jpanos/ECE477-PCB/ECE477.kicad_pcb

## KiCad design ECE477.kicad_pcb (2020-10-26)

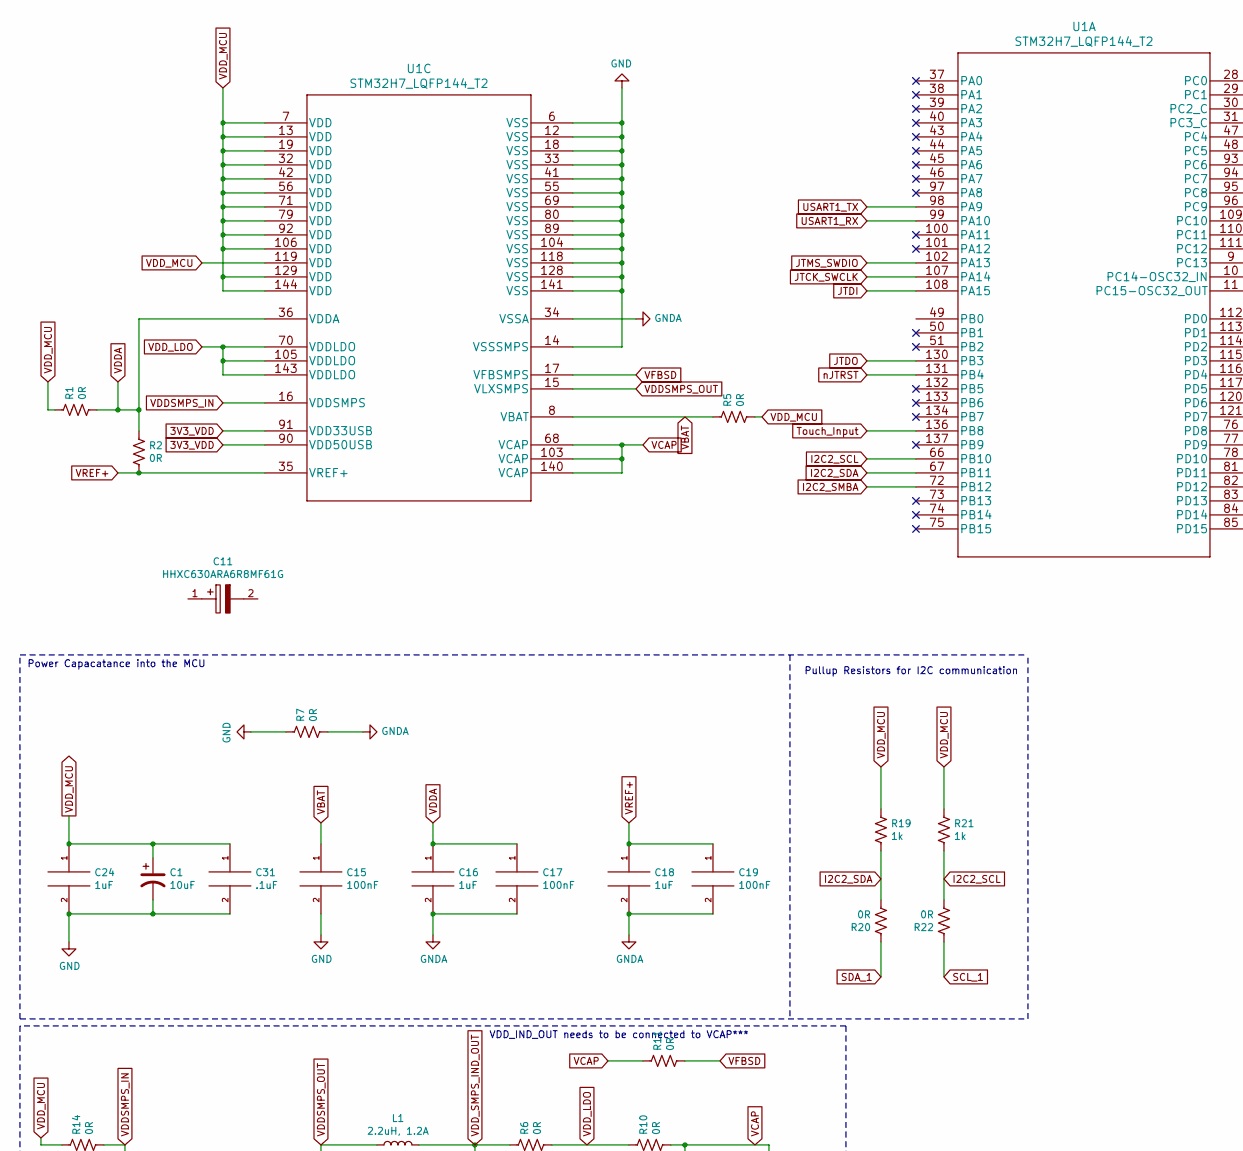
[picture p1: schematic ECE477.sch, ECE 477 PCB, part in row 1, column 1]

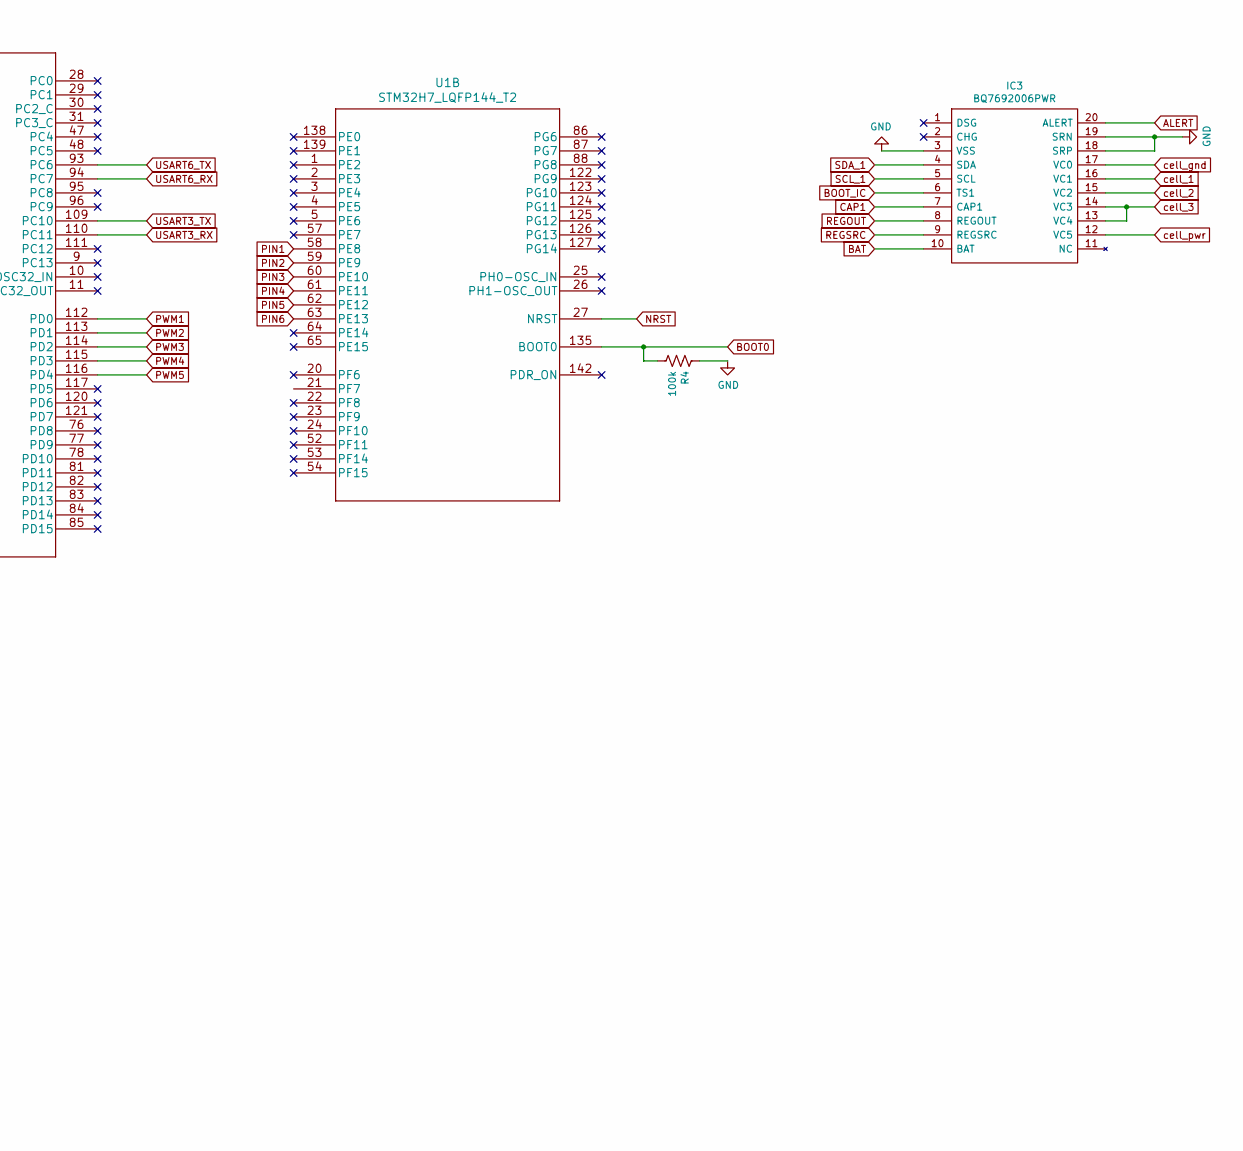
[picture p2: schematic ECE477.sch, ECE 477 PCB, part in row 1, column 2]

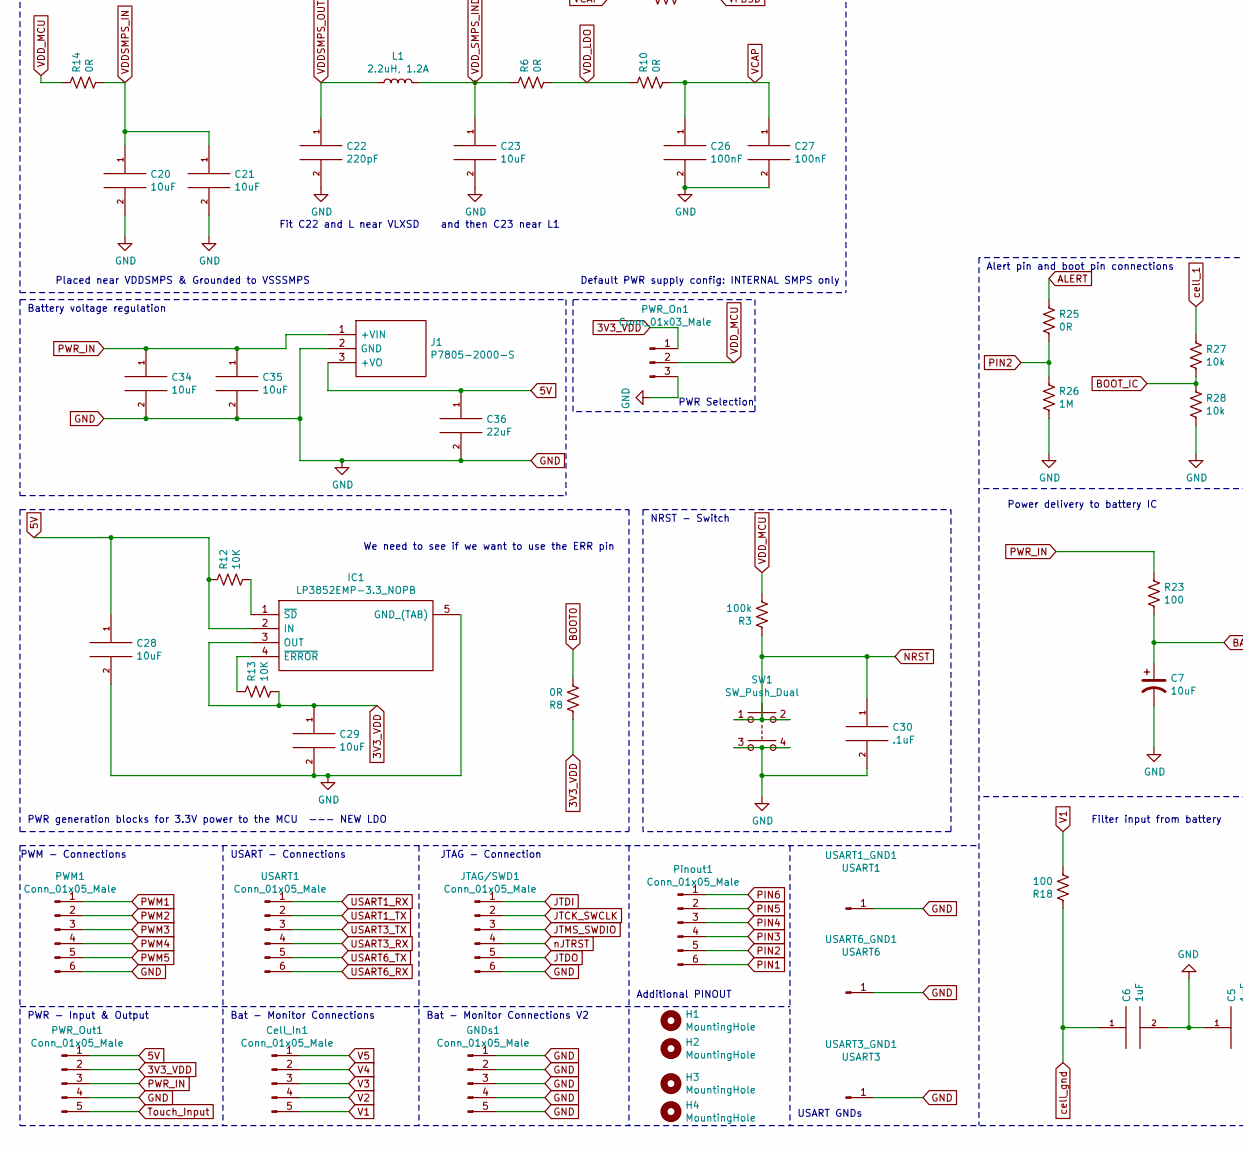
[picture p3: schematic ECE477.sch, ECE 477 PCB, part in row 2, column 1]

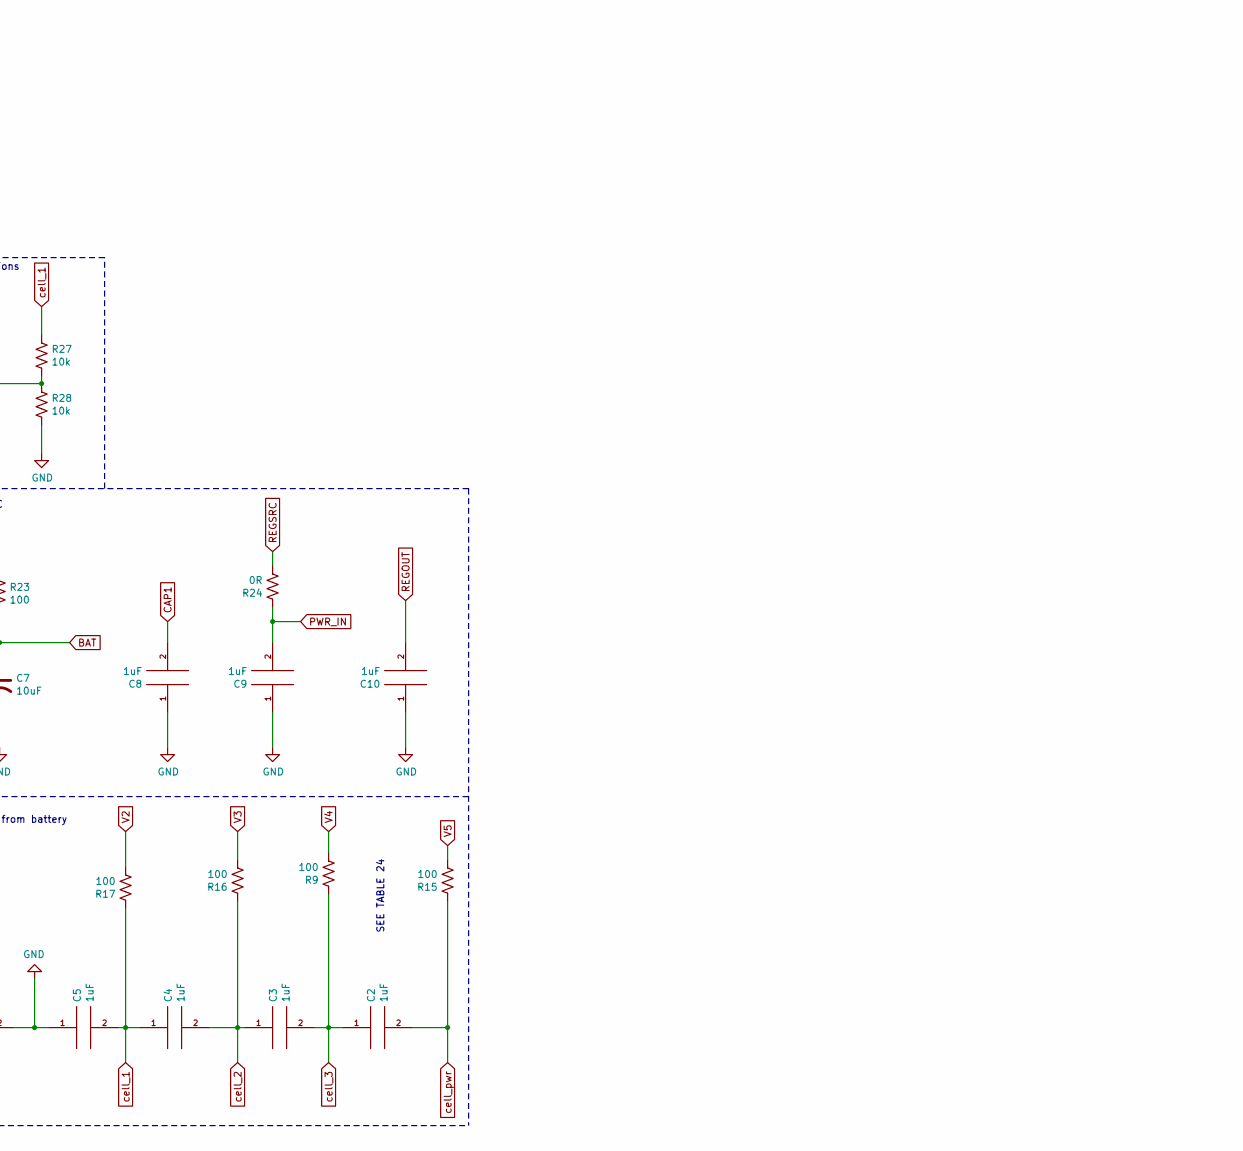
[picture p4: schematic ECE477.sch, ECE 477 PCB, part in row 2, column 2]

Parts:
C1, C7: 10uF; CP_Radial_D5.0mm_P2.50mm
C2, C3, C4, C5, C6, C8, C9, C10, C16, C18, C24: 1uF; C_0805_2012Metric_Pad1.15x1.40mm_HandSolder
C11: HHXC630ARA6R8MF61G; CAPAE660X610N; Mouser Part Number 661-HHXC630A6R8MF61G
C15, C17, C19, C26, C27: 100nF; C_0805_2012Metric_Pad1.15x1.40mm_HandSolder
C20, C21, C23, C28, C29, C34, C35: 10uF; C_0805_2012Metric_Pad1.15x1.40mm_HandSolder
C22: 220pF; C_0805_2012Metric_Pad1.15x1.40mm_HandSolder
C30, C31: .1uF; C_0805_2012Metric_Pad1.15x1.40mm_HandSolder
C36: 22uF; C_0805_2012Metric_Pad1.15x1.40mm_HandSolder
Cell_In1: Conn_01x05_Male; PinHeader_1x05_P2.54mm_Vertical
GNDs1: Conn_01x05_Male; PinHeader_1x05_P2.54mm_Vertical
H1, H2, H3, H4: MountingHole; MountingHole_3.2mm_M3_ISO14580
IC1: LP3852EMP-3.3_NOPB; SOT150P700X180-5N; Mouser Part Number 926-LP3852EMP33NOPB
IC3: BQ7692006PWR; SOP65P640X120-20N; Mouser Part Number 595-BQ7692006PWR
J1: P7805-2000-S; P78052000S; Mouser Part Number 490-P7805-2000-S
JTAG/SWD1: Conn_01x05_Male; PinHeader_1x06_P2.54mm_Vertical
L1: 2.2uH, 1.2A; L_0805_2012Metric_Pad1.15x1.40mm_HandSolder
PWM1: Conn_01x05_Male; PinHeader_1x06_P2.54mm_Vertical
PWR_On1: Conn_01x03_Male; PinHeader_1x03_P2.54mm_Vertical
PWR_Out1: Conn_01x05_Male; PinHeader_1x05_P2.54mm_Vertical
Pinout1: Conn_01x05_Male; PinHeader_1x06_P2.54mm_Vertical
R1, R2, R5, R6, R7, R8, R10, R11, R14, R20, R22, R24, R25: 0R; R_0805_2012Metric_Pad1.15x1.40mm_HandSolder
R3, R4: 100k; R_0805_2012Metric_Pad1.15x1.40mm_HandSolder
R9, R15, R16, R17, R18, R23: 100; R_0805_2012Metric_Pad1.15x1.40mm_HandSolder
R12, R13: 10K; R_0805_2012Metric_Pad1.15x1.40mm_HandSolder
R19, R21: 1k; R_0805_2012Metric_Pad1.15x1.40mm_HandSolder
R26: 1M; R_0805_2012Metric_Pad1.15x1.40mm_HandSolder
R27, R28: 10k; R_0805_2012Metric_Pad1.15x1.40mm_HandSolder
SW1: SW_Push_Dual; SW_TH_Tactile_Omron_B3F-10xx
U1: STM32H7_LQFP144_T2
USART1: Conn_01x05_Male; PinHeader_1x06_P2.54mm_Vertical
USART1_GND1: USART1; PinHeader_1x01_P2.54mm_Vertical
USART3_GND1: USART3; PinHeader_1x01_P2.54mm_Vertical
USART6_GND1: USART6; PinHeader_1x01_P2.54mm_Vertical

Connections:
3V3_VDD: C29.1, IC1.3 (OUT), PWR_On1.1, PWR_Out1.2, R8.1, R13.2, U1.90 (VDD50USB), U1.91 (VDD33USB)
5V: C28.1, C36.1, IC1.2 (IN), J1.3 (+VO), PWR_Out1.1, R12.1
ALERT: IC3.20 (ALERT), R25.1
BAT: C7.1, IC3.10 (BAT), R23.2
BOOT0: R4.2, R8.2, U1.135 (BOOT0)
BOOT_IC: IC3.6 (TS1), R27.2, R28.1
CAP1: C8.2, IC3.7 (CAP1)
GND: C1.2, C5.1, C6.2, C7.2, C8.1, C9.1, C10.1, C15.2, C20.2, C21.2, C22.2, C23.2, C24.2, C26.2, C27.2, C28.2, C29.2, C30.2, C31.2, C34.2, C35.2, C36.2, GNDs1.1, GNDs1.2, GNDs1.3, GNDs1.4, GNDs1.5, IC1.5 (GND_(TAB)), IC3.3 (VSS), IC3.18 (SRP), IC3.19 (SRN), J1.2 (GND), JTAG/SWD1.6, PWM1.6, PWR_On1.3, PWR_Out1.4, R4.1, R7.1, R26.2, R28.2, SW1.3, SW1.4, U1.6 (VSS), U1.12 (VSS), U1.14 (VSSSMPS), U1.18 (VSS), U1.33 (VSS), U1.41 (VSS), U1.55 (VSS), U1.69 (VSS), U1.80 (VSS), U1.89 (VSS), U1.104 (VSS), U1.118 (VSS), U1.128 (VSS), U1.141 (VSS), USART1_GND1.1, USART3_GND1.1, USART6_GND1.1
GNDA: C16.2, C17.2, C18.2, C19.2, R7.2, U1.34 (VSSA)
I2C2_SCL: R21.2, R22.2, U1.66 (PB10)
I2C2_SDA: R19.2, R20.2, U1.67 (PB11)
I2C2_SMBA: U1.72 (PB12)
JTCK_SWCLK: JTAG/SWD1.2, U1.107 (PA14)
JTDI: JTAG/SWD1.1, U1.108 (PA15)
JTDO: JTAG/SWD1.5, U1.130 (PB3)
JTMS_SWDIO: JTAG/SWD1.3, U1.102 (PA13)
NRST: C30.1, R3.1, SW1.1, SW1.2, U1.27 (NRST)
unnamed: IC1.1 (~SD), R12.2
unnamed: IC1.4 (~ERROR), R13.1
PIN1: Pinout1.6, U1.58 (PE8)
PIN2: Pinout1.5, R25.2, R26.1, U1.59 (PE9)
PIN3: Pinout1.4, U1.60 (PE10)
PIN4: Pinout1.3, U1.61 (PE11)
PIN5: Pinout1.2, U1.62 (PE12)
PIN6: Pinout1.1, U1.63 (PE13)
PWM1: PWM1.1, U1.112 (PD0)
PWM2: PWM1.2, U1.113 (PD1)
PWM3: PWM1.3, U1.114 (PD2)
PWM4: PWM1.4, U1.115 (PD3)
PWM5: PWM1.5, U1.116 (PD4)
PWR_IN: C9.2, C34.1, C35.1, J1.1 (+VIN), PWR_Out1.3, R23.1, R24.1
REGOUT: C10.2, IC3.8 (REGOUT)
REGSRC: IC3.9 (REGSRC), R24.2
SCL_1: IC3.5 (SCL), R22.1
SDA_1: IC3.4 (SDA), R20.1
Touch_Input: PWR_Out1.5, U1.136 (PB8)
USART1_RX: U1.99 (PA10), USART1.1
USART1_TX: U1.98 (PA9), USART1.2
USART3_RX: U1.110 (PC11), USART1.4
USART3_TX: U1.109 (PC10), USART1.3
USART6_RX: U1.94 (PC7), USART1.6
USART6_TX: U1.93 (PC6), USART1.5
V1: Cell_In1.5, R18.2
V2: Cell_In1.4, R17.2
V3: Cell_In1.3, R16.2
V4: Cell_In1.2, R9.2
V5: Cell_In1.1, R15.2
VBAT: C15.1, R5.1, U1.8 (VBAT)
VCAP: C26.1, C27.1, R10.2, R11.1, U1.68 (VCAP), U1.103 (VCAP), U1.140 (VCAP)
VDDA: C16.1, C17.1, R1.2, R2.1, U1.36 (VDDA)
VDDSMPS_IN: C20.1, C21.1, R14.2, U1.16 (VDDSMPS)
VDDSMPS_OUT: C22.1, L1.1, U1.15 (VLXSMPS)
VDD_LDO: R6.2, R10.1, U1.70 (VDDLDO), U1.105 (VDDLDO), U1.143 (VDDLDO)
VDD_MCU: C1.1, C24.1, C31.1, PWR_On1.2, R1.1, R3.2, R5.2, R14.1, R19.1, R21.1, U1.7 (VDD), U1.13 (VDD), U1.19 (VDD), U1.32 (VDD), U1.42 (VDD), U1.56 (VDD), U1.71 (VDD), U1.79 (VDD), U1.92 (VDD), U1.106 (VDD), U1.119 (VDD), U1.129 (VDD), U1.144 (VDD)
VDD_SMPS_IND_OUT: C23.1, L1.2, R6.1
VFBSD: R11.2, U1.17 (VFBSMPS)
VREF+: C18.1, C19.1, R2.2, U1.35 (VREF+)
cell_1: C4.1, C5.2, IC3.16 (VC1), R17.1, R27.1
cell_2: C3.1, C4.2, IC3.15 (VC2), R16.1
cell_3: C2.1, C3.2, IC3.13 (VC4), IC3.14 (VC3), R9.1
cell_gnd: C6.1, IC3.17 (VC0), R18.1
cell_pwr: C2.2, IC3.12 (VC5), R15.1
nJTRST: JTAG/SWD1.4, U1.131 (PB4)

Notes on the sheet:
Placed near VDDSMPS & Grounded to VSSSMPS
Fit C22 and L near VLXSD and then C23 near L1
Default PWR supply config: INTERNAL SMPS only
VDD_IND_OUT needs to be connected to VCAP***
Battery voltage regulation
PWR Selection
Power Capacatance into the MCU
Bat - Monitor Connections
PWR - Input & Output
NRST - Switch
PWM - Connections
USART - Connections
JTAG - Connection
PWR generation blocks for 3.3V power to the MCU --- NEW LDO
We need to see if we want to use the ERR pin
Bat - Monitor Connections V2
USART GNDs
Additional PINOUT
SEE TABLE 24
Filter input from battery
Power delivery to battery IC
Pullup Resistors for I2C communication
Alert pin and boot pin connections

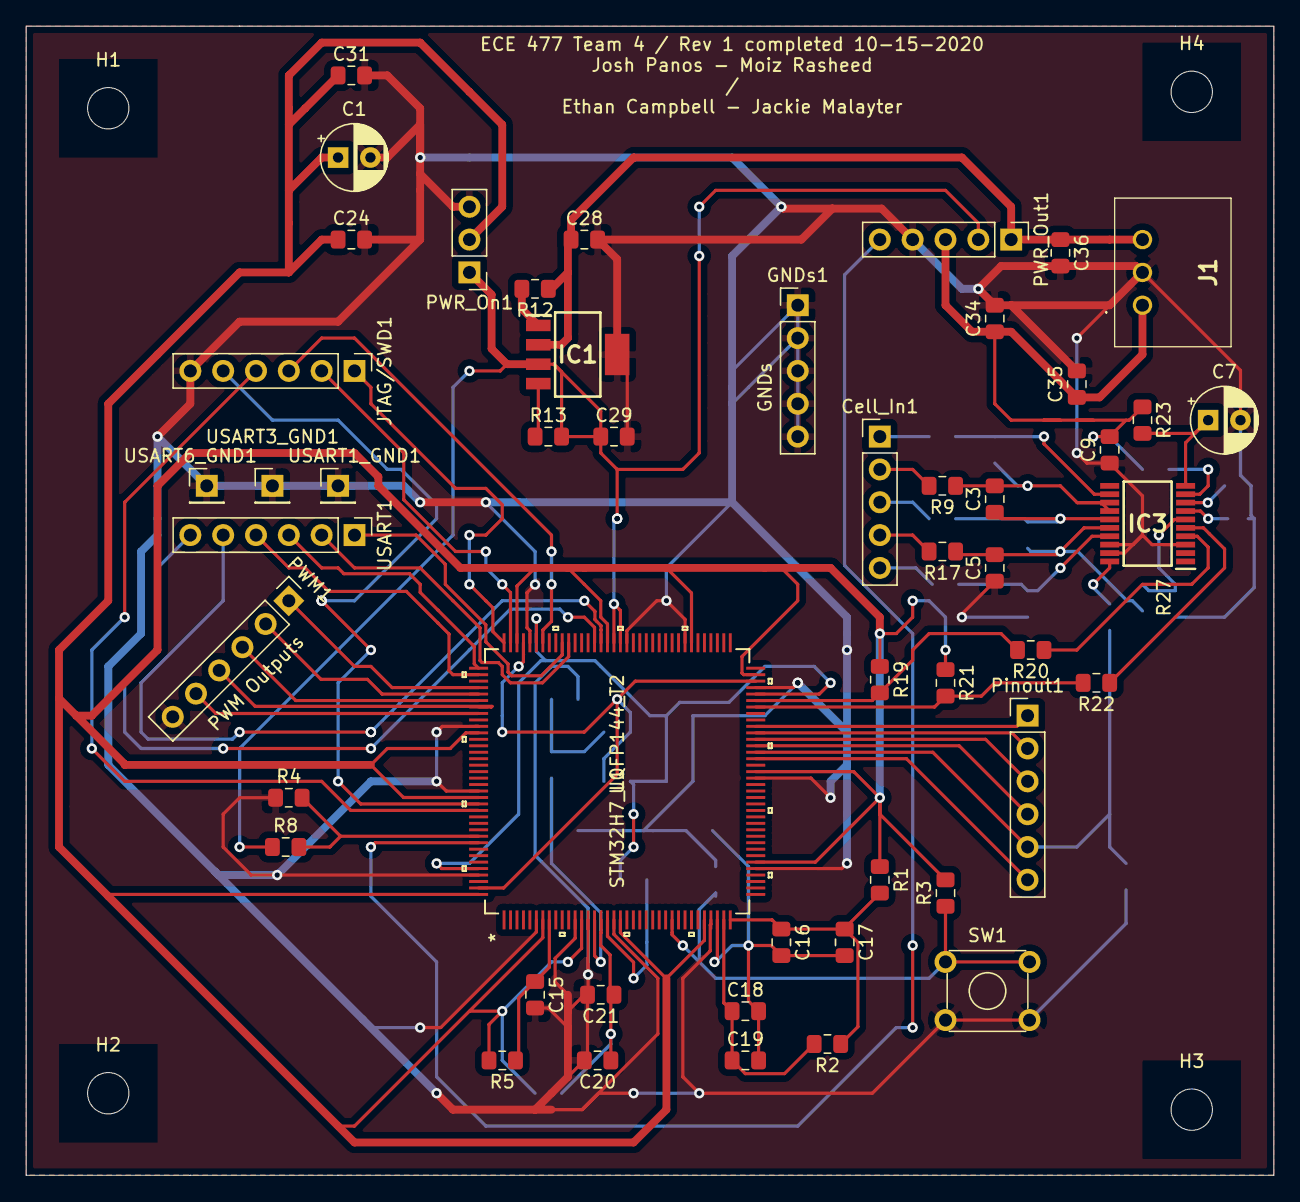
[picture p5: board ECE477.kicad_pcb from above]

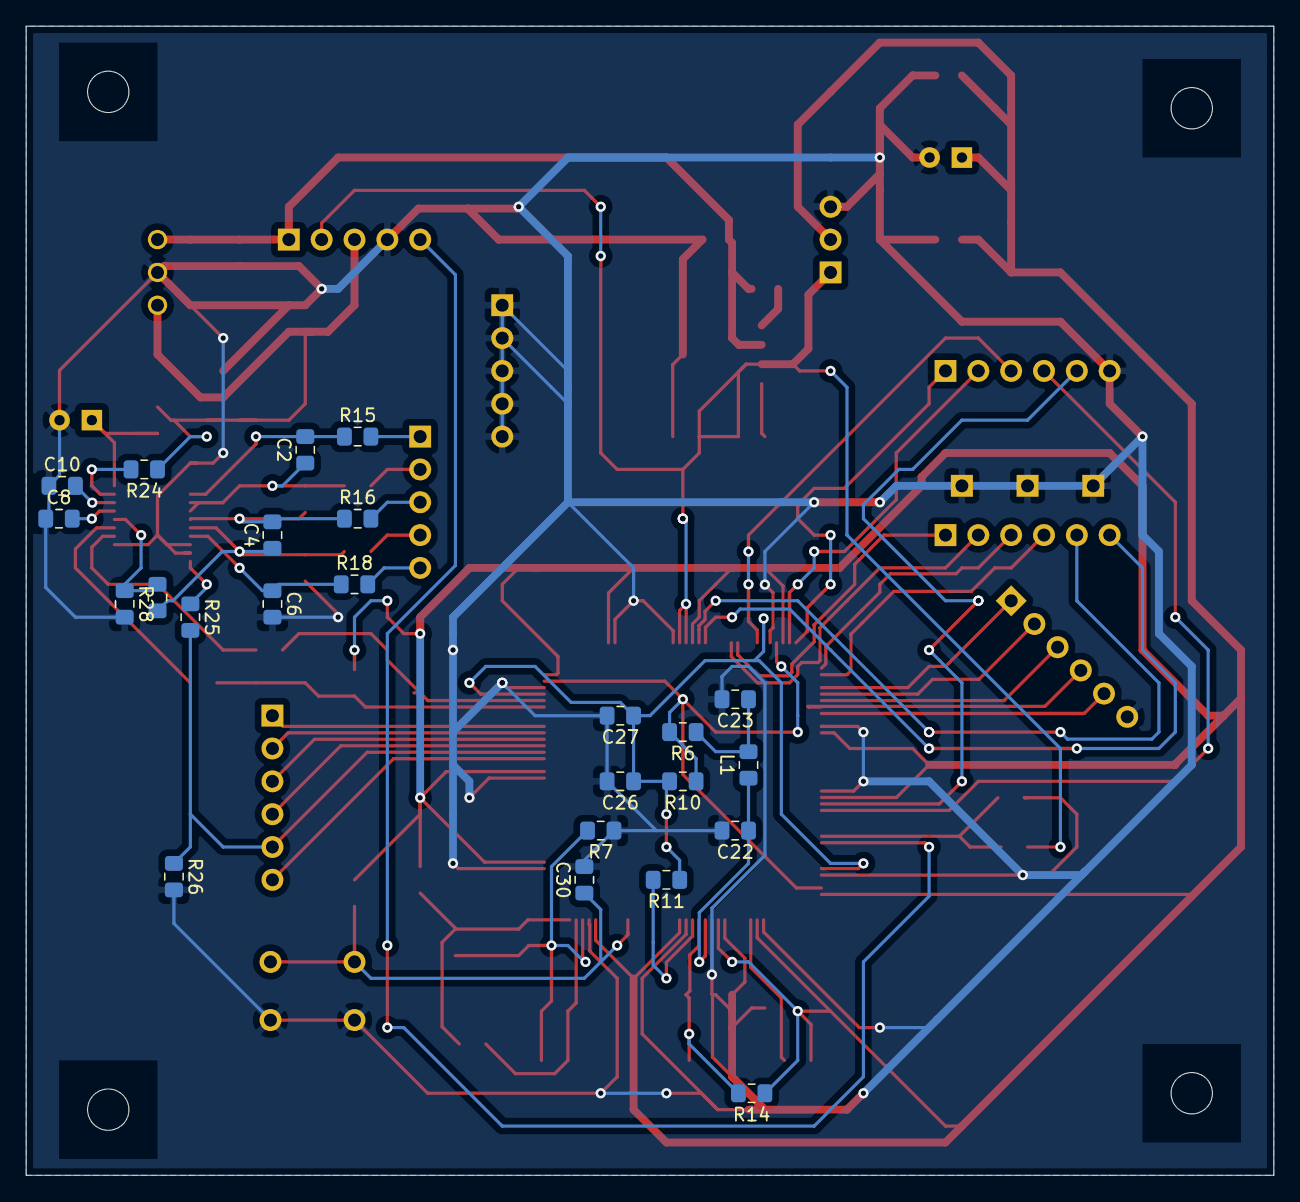
[picture p6: board ECE477.kicad_pcb from below]

Board: 2 copper layers, 96.5 x 88.9 mm, 78 parts (24 on the bottom side), 62 nets.
