jpanos/ECE477-PCB/(commit log)

2020-09-20 Working PCB code
    [ECE477.kicad_pcb, ECE477.sch]
2020-09-21 Adding in libraies
    [ECE477.sch, familylist_refdes.csv]
2020-09-21 ALl libaries
    Added all libaries used for the current KiCAD
2020-09-21 Added Power Scheme 2
    Default power scheme added with SMPS on and LDO off.
    [ECE477.sch]
2020-09-21 Updated
    Annotated Schematic
    [ECE477.sch]
2020-09-21 Adding new librarys
    Added new libraries for more PCB power delivery. Also continuing to update PCB PWR wiring with 3.3 and 1.8V generation
    [ECE477.sch]
2020-09-21 Rapair
    Repaired Libary miss configuration Should no longer be issues with loading the STM32
    [ECE477.sch]
2020-09-21 Added 3.3V and 1.8V power generation
    [ECE477.sch]
2020-09-21 Added pins for JTAG & USART1
    [ECE477.sch]
2020-09-22 Added in Battery Regulator
    [ECE477.sch]
2020-09-22 New battery monitor
    Changed thebattery monitor IC to a similar one due to first chip not beign avaliable
    [ECE477.sch]
2020-09-24 Footprints
    Added footprints to all componets and changed some library associations around.
    [ECE477.kicad_pcb, ECE477.sch]
2020-09-24 Removing the 1V8 pwr supply
    [ECE477.sch]
2020-09-24 Adding info to battery monitor
    [ECE477.sch]
2020-09-28 Working on PCB
    Working on layout
    [ECE477.sch]
2020-09-28 Wiring for the NEW LDO
    [ECE477.sch]
2020-09-28 FIxing issues with the schematic import that I did not notice
    [ECE477.kicad_pcb, ECE477.sch]
2020-09-28 Added what needs to be done on schematic
    [ECE477.sch]
2020-09-30 Adding NRST + Boot
    Added NRST + Boot
    [ECE477.sch]
2020-09-30 Pinouts
    Pin outs for USART GPIO and JTAG
    [ECE477.sch]
2020-09-30 Added Pinout
    Added footprints and pinout connections
    [ECE477.kicad_pcb, ECE477.sch]
2020-10-01 Updated post review with team members
    [ECE477.kicad_pcb, ECE477.sch]
2020-10-01 Finalized Pinout
    [ECE477.sch]
2020-10-01 Label and layout updates
    Updated Labesl for simplicity along with a starting footprint layout for our PCB.
    [ECE477.kicad_pcb, ECE477.sch]
2020-10-01 Post meeting with TODD
    [ECE477.sch]
2020-10-02 Updated PACK and BAT
    [ECE477.sch]
2020-10-05 Updated Bat monitor
    [ECE477.sch]
2020-10-05 Working with Routing
    [ECE477.kicad_pcb, ECE477.sch]
2020-10-07 Finshed Routing One
    [ECE477.kicad_pcb, ECE477.sch]
2020-10-07 updated NRST capacitor location closer to MCU
    [ECE477.kicad_pcb]
2020-10-08 review with team
    [ECE477.kicad_pcb, ECE477.sch]
2020-10-08 Added ground planes
    [ECE477.kicad_pcb]
2020-10-08 filled zones
    [ECE477.kicad_pcb]
2020-10-08 Updated CLK for Bq29330DBT
    [ECE477.kicad_pcb, ECE477.sch]
2020-10-08 Added mounting Holes
    [ECE477.kicad_pcb]
2020-10-08 Updates #1 post meeting with TODD
    Updated pins and added GNDs for serial communication refreces.
    [ECE477.kicad_pcb, ECE477.sch]
2020-10-10 Updated with single cap
    [ECE477.kicad_pcb, ECE477.sch]
2020-10-13 Shrunk PCB size
    [ECE477.kicad_pcb]
2020-10-14 Added additional outputs on GPIOE
    [ECE477.kicad_pcb, ECE477.sch]
2020-10-15 Updated USART GND
    [ECE477.kicad_pcb]
2020-10-15 Update with pins
    [ECE477.sch]
2020-10-15 DRC corrections
    [ECE477.kicad_pcb]
2020-10-15 Board label
    [ECE477.kicad_pcb]
2020-10-23 Major change
    [ECE477.kicad_pcb, ECE477.sch]
2020-10-23 Updated layout
    [ECE477.kicad_pcb]
2020-10-23 Fixed DRC issue
    [ECE477.kicad_pcb]
2020-10-23 Changed mounting holes
    [ECE477.kicad_pcb]
2020-10-23 Updates post meeting with Todd
    [ECE477.kicad_pcb, ECE477.sch]
2020-10-26 Generated Gerbers
    [ECE477-B_Cu.gbr, ECE477-B_Mask.gbr, ECE477-B_Paste.gbr, ECE477-B_SilkS.gbr, ECE477-Edge_Cuts.gbr, ECE477-F_Cu.gbr, ECE477-F_Mask.gbr, ECE477-F_Paste.gbr]
